varaddorle007/deck-8/docs/images/schematic-root.png

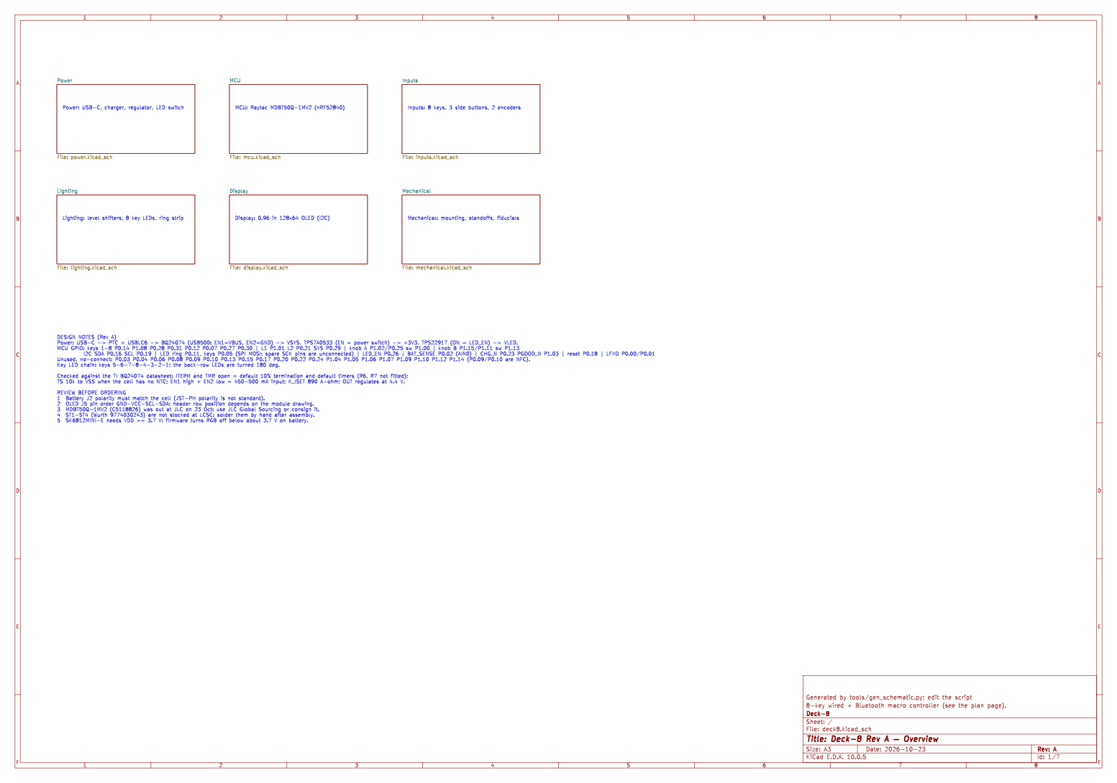
docs/images/schematic-root.png
