varaddorle007/deck-8/mechanical/exports/views_contact_sheet.png

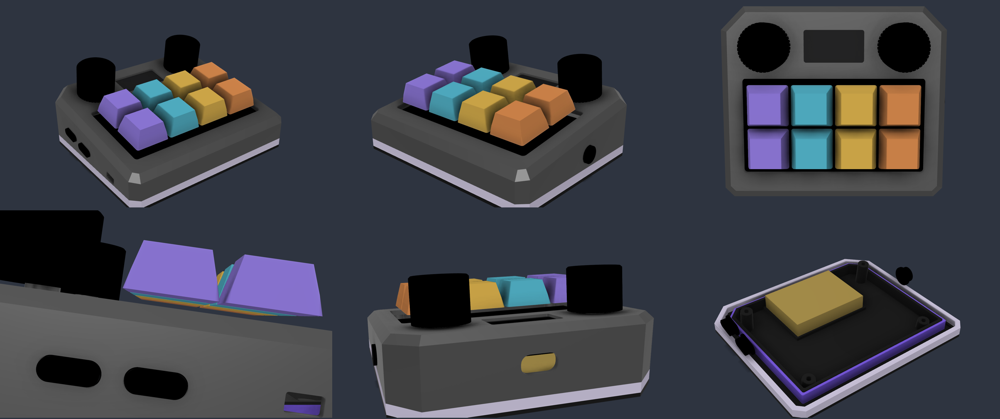
mechanical/exports/views_contact_sheet.png
