varaddorle007/deck-8/release/deck8-RevA-manufacturing/1-PCB-order-JLCPCB/deck8-RevA-bom-jlc.csv

Comment | Designator | Footprint | LCSC Part #
1u 25V CL10A105KB8NNNC (50 V X5R) | C1,C5,C7 | C_0603_1608Metric | C15849
10u 10V CL10A106KP8NNNC (10 V X5R) | C2,C9,C10,C26 | C_0603_1608Metric | C19702
4.7u 10V CL10A475KO8NNNC (16 V X5R) | C3,C12 | C_0603_1608Metric | C19666
100n CC0603KRX7R9BB104 (50 V X7R) | C4,C11,C15,C16,C17,C18,C19,C20,C21,C22,C23,C24,C27 | C_0603_1608Metric | C14663
2.2u 10V CL10A225KO8NNNC (16 V X5R) | C6 | C_0603_1608Metric | C23630
1n CL10B102KB8NNNC (50 V X7R) | C8 | C_0603_1608Metric | C1588
12p CL10C120JB8NNNC (50 V C0G) | C13,C14 | C_0603_1608Metric | C38523
100u 6.3V CL31A107MQHNNNE (1206, 6.3 V X5R) | C25 | C_1206_3216Metric | C15008
OPSCO SK6812MINI-E | D1,D2,D3,D4,D5,D6,D7,D8 | LED_SK6812MINI-E_3.2x2.8mm_P1.5mm_ReverseMount | C5149201
Littelfuse 1206L050YR (6 V) | F1 | Fuse_1206_3216Metric | C163512
HRO TYPE-C-31-M-12 | J1 | USB_C_Receptacle_HRO_TYPE-C-31-M-12 | C165948
JST S2B-PH-SM4-TB(LF)(SN) | J2 | JST_PH_S2B-PH-SM4-TB_1x02-1MP_P2.00mm_Horizontal | C295747
Joint Tech A1001WR-S-03P (JST SH compatible) | J4 | JST_SH_SM03B-SRSS-TB_1x03-1MP_P1.00mm_Horizontal | C371509
HanElectricity CPG151101S11-16 (MX hot-swap socket) | K1,K2,K3,K4,K5,K6,K7,K8 | SW_MX_Hotswap_Kailh_1u_NorthLED | C41430893
5.1k UNI-ROYAL 0603WAF5101T5E | R1,R2 | R_0603_1608Metric | C23186
10k UNI-ROYAL 0603WAF1002T5E | R3 | R_0603_1608Metric | C25804
1.8k UNI-ROYAL 0603WAF1801T5E | R4 | R_0603_1608Metric | C4177
1.5k UNI-ROYAL 0603WAF1501T5E | R5 | R_0603_1608Metric | C22843
100k UNI-ROYAL 0603WAF1003T5E | R8,R9,R13 | R_0603_1608Metric | C25803
1M UNI-ROYAL 0603WAF1004T5E | R10,R11,R12 | R_0603_1608Metric | C22935
0R UNI-ROYAL 0603WAF0000T5E | R14,R15,R20 | R_0603_1608Metric | C21189
33 UNI-ROYAL 0603WAF330JT5E | R16 | R_0603_1608Metric | C23140
330 UNI-ROYAL 0603WAF3300T5E | R17 | R_0603_1608Metric | C23138
4.7k UNI-ROYAL 0603WAF4701T5E | R18,R19 | R_0603_1608Metric | C23162
C&K PCM12SMTR | SW1 | SW_SPDT_PCM12 | C221841
C&K PTS810SJK250SMTRLFS | SW2 | SW_SPST_PTS810 | C221896
Alps SKRTLAE010 | SW3,SW4,SW5 | SW_Push_1P1T-MP_NO_Horizontal_Alps_SKRTLAE010 | C110293
ST USBLC6-2SC6 | U1 | SOT-23-6 | C7519
TI BQ24074RGTT | U2 | VQFN-16-1EP_3x3mm_P0.5mm_EP1.6x1.6mm_ThermalVias | C2861252
TI TPS7A0533PDBVR | U3 | SOT-23-5 | C493453
TI TPS22917DBVR | U4 | SOT-23-6 | C2681320
Raytac MDBT50Q-1MV2 | U5 | Raytac_MDBT50Q | C5118826
TI SN74LV1T125DBVR | U6,U7 | SOT-23-5 | C473338
Seiko SC-32S 32.768kHz 20ppm 9pF | Y1 | Crystal_SMD_3215-2Pin_3.2x1.5mm | C97605
