varaddorle007/deck-8/mechanical/exports/deck8_assembly.step

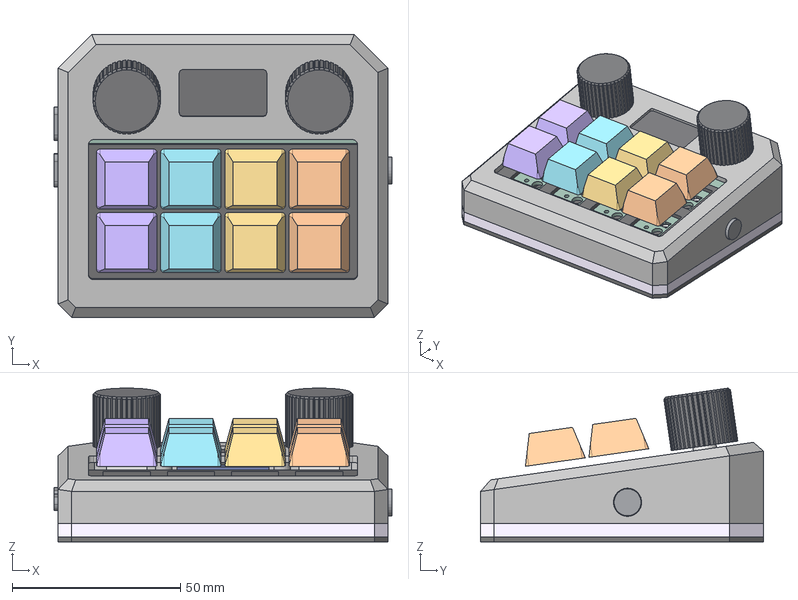
[picture p22: CAD file, 2026-10-23]
mechanical/exports/deck8_assembly.step
100.4 x 84.0 x 45.7 mm
Fusion_sp
C_0603_1608Metric_1 x 26
SOT-23-5_1 x 3
R_0603_1608Metric_1 x 20
C_1206_3216Metric_1
SOT-23-6_1 x 2
Mounting_Wuerth_WA-SMSI-M2_H3mm_9774030243_1 x 4
Pin1 x 8
Pin2 x 8
Pin3 x 8
Pin4 x 8
Crystal_SMD_3215-2Pin_3.2x1.5mm_1
JST_SH_SM03B-SRSS-TB_1x03-1MP_P1.00mm_Horizontal_1
SW_SPST_PTS810_1
Fuse_1206_3216Metric_1
Raytac_MDBT50Q_1
deck8_PCB
