varaddorle007/deck-8/hardware/exports/deck8_pcb.step

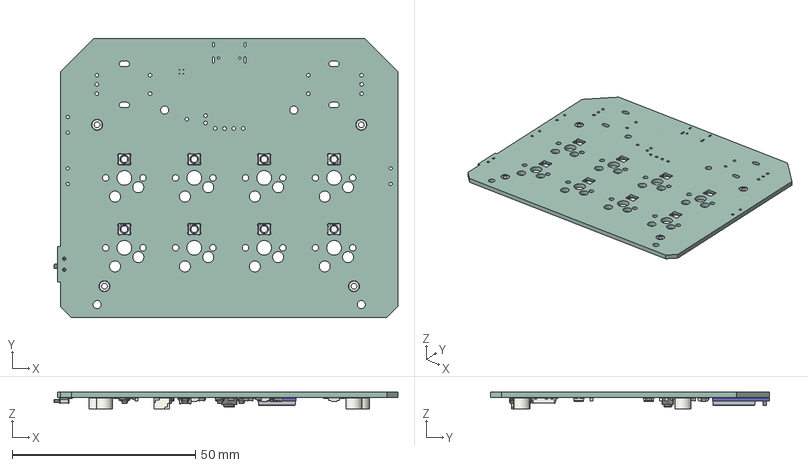
[picture p23: CAD file, 2026-10-23]
hardware/exports/deck8_pcb.step
93.8 x 76.0 x 4.60 mm
Fusion_sp
C_0603_1608Metric x 26
SOT-23-5 x 3
R_0603_1608Metric x 20
C_1206_3216Metric
SOT-23-6 x 2
Mounting_Wuerth_WA-SMSI-M2_H3mm_9774030243 x 4
Pin1 x 8
Pin2 x 8
Pin3 x 8
Pin4 x 8
Crystal_SMD_3215-2Pin_3.2x1.5mm
JST_SH_SM03B-SRSS-TB_1x03-1MP_P1.00mm_Horizontal
SW_SPST_PTS810
Fuse_1206_3216Metric
Raytac_MDBT50Q
deck8_PCB
