varaddorle007/deck-8/mechanical/exports/stl/Button_System.stl

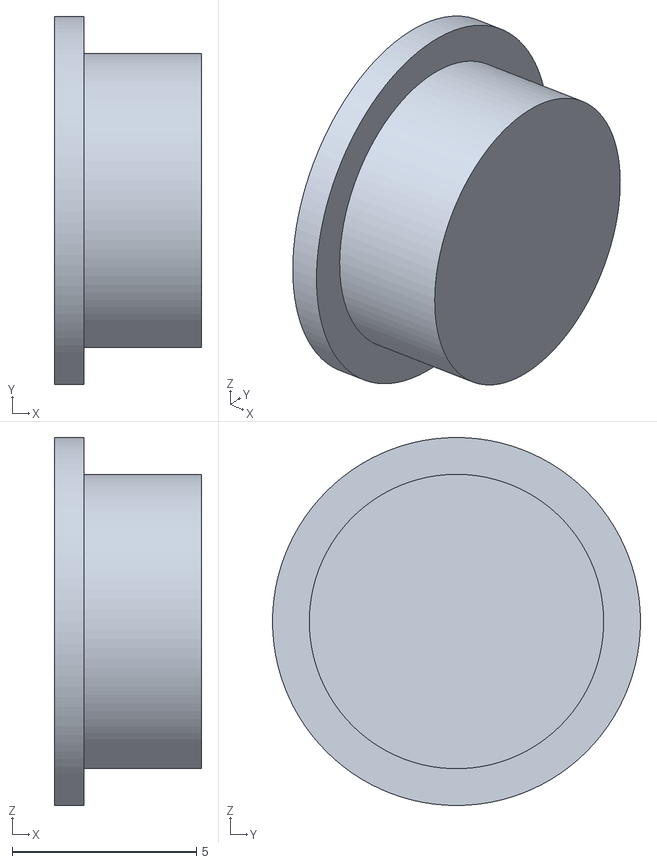
[picture p24: CAD file, 2026-10-23]
mechanical/exports/stl/Button_System.stl
4.00 x 10.0 x 10.00
