varaddorle007/deck-8/release/deck8-RevA-manufacturing/3-Enclosure/laser-cut-DXF/Deck8_Switch_Plate_1.5mm.dxf

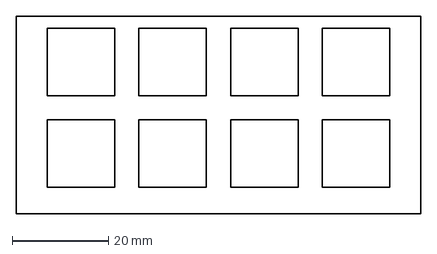
[picture p25: CAD file, 2026-10-23]
release/deck8-RevA-manufacturing/3-Enclosure/laser-cut-DXF/Deck8_Switch_Plate_1.5mm.dxf
84.0 x 41.0 mm
