varaddorle007/deck-8/release/deck8-RevA-manufacturing/3-Enclosure/print-STL/Deck8_Light_Ring.stl

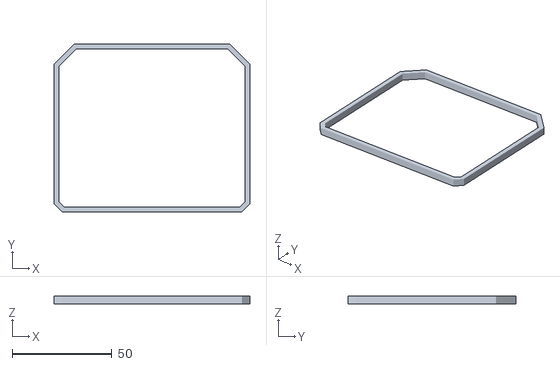
[picture p26: CAD file, 2026-10-23]
release/deck8-RevA-manufacturing/3-Enclosure/print-STL/Deck8_Light_Ring.stl
98.0 x 84.0 x 4.00
