varaddorle007/deck-8/mechanical/exports/stl/Button_L1.stl

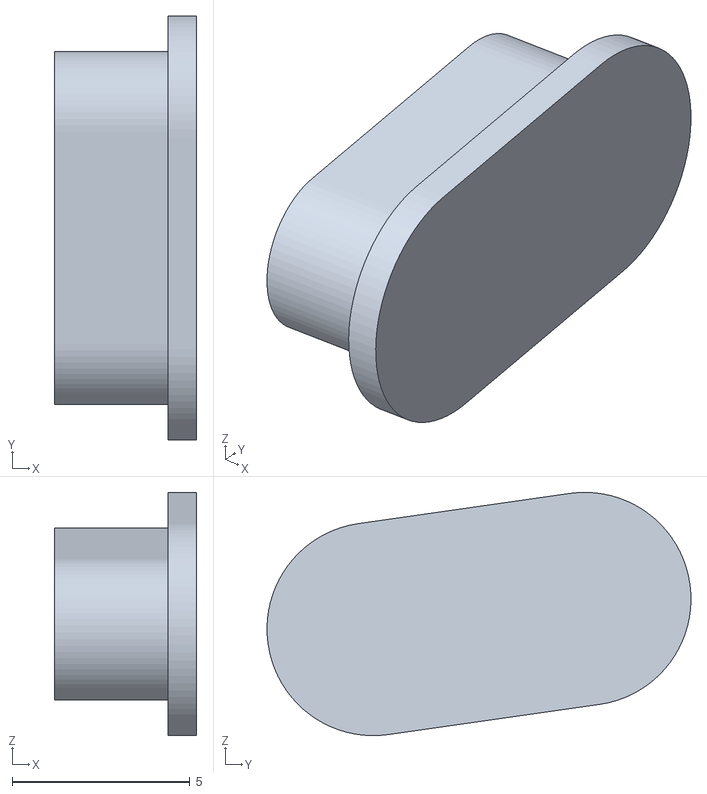
[picture p27: CAD file, 2026-10-23]
mechanical/exports/stl/Button_L1.stl
4.00 x 11.9 x 6.85
