varaddorle007/deck-8/release/deck8-RevA-manufacturing/3-Enclosure/laser-cut-DXF/Deck8_OLED_Lens_1mm_acrylic.dxf

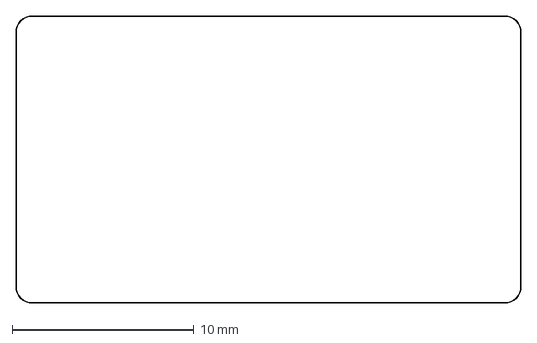
[picture p28: CAD file, 2026-10-23]
release/deck8-RevA-manufacturing/3-Enclosure/laser-cut-DXF/Deck8_OLED_Lens_1mm_acrylic.dxf
27.8 x 15.8 mm
