varaddorle007/deck-8/mechanical/exports/stl/Top_Shell.stl

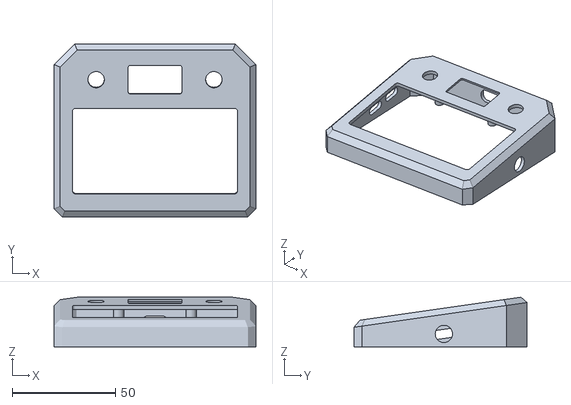
[picture p29: CAD file, 2026-10-23]
mechanical/exports/stl/Top_Shell.stl
98.0 x 84.0 x 24.1
