varaddorle007/deck-8/mechanical/exports/stl/OLED_Lens.stl

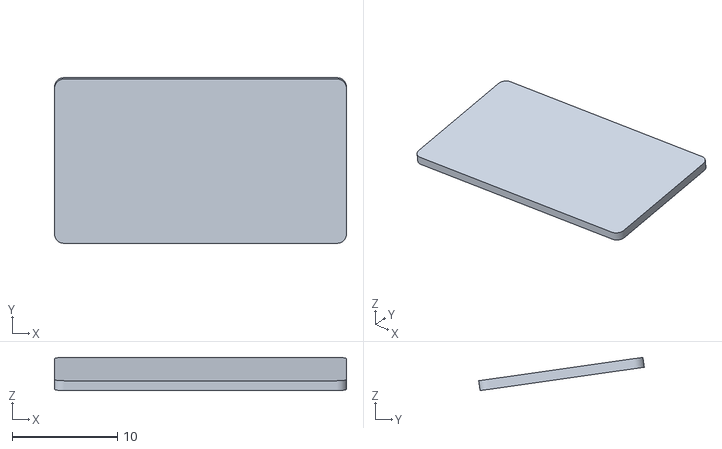
[picture p30: CAD file, 2026-10-23]
mechanical/exports/stl/OLED_Lens.stl
27.8 x 15.8 x 3.17
