varaddorle007/deck-8/release/deck8-RevA-manufacturing/3-Enclosure/print-STL/Deck8_Knob_x2.stl

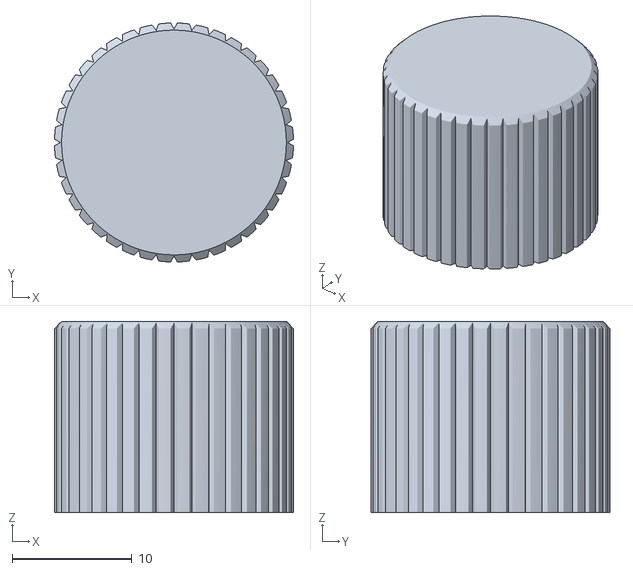
[picture p31: CAD file, 2026-10-23]
release/deck8-RevA-manufacturing/3-Enclosure/print-STL/Deck8_Knob_x2.stl
20.0 x 20.0 x 16.0
