varaddorle007/deck-8/mechanical/exports/stl/Switch_Plate.stl

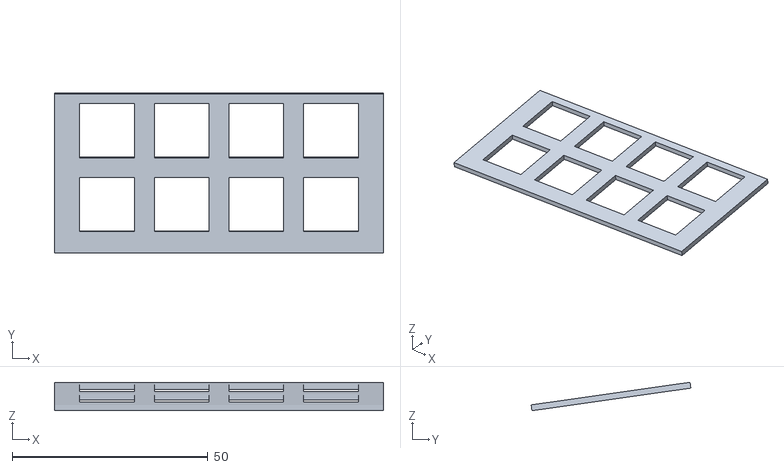
[picture p32: CAD file, 2026-10-23]
mechanical/exports/stl/Switch_Plate.stl
84.0 x 40.8 x 7.26
