varaddorle007/deck-8/release/deck8-RevA-manufacturing/3-Enclosure/print-STL/Deck8_Bottom_Tray.stl

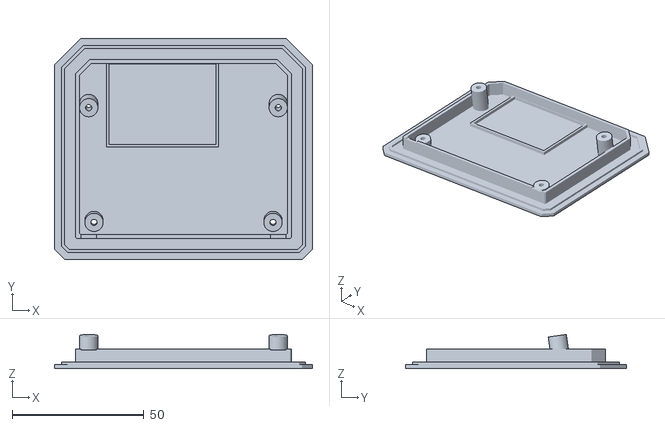
[picture p33: CAD file, 2026-10-23]
release/deck8-RevA-manufacturing/3-Enclosure/print-STL/Deck8_Bottom_Tray.stl
98.0 x 84.0 x 13.0
