varaddorle007/deck-8/release/deck8-RevA-manufacturing/3-Enclosure/print-STL/Deck8_Switch_Plate.stl

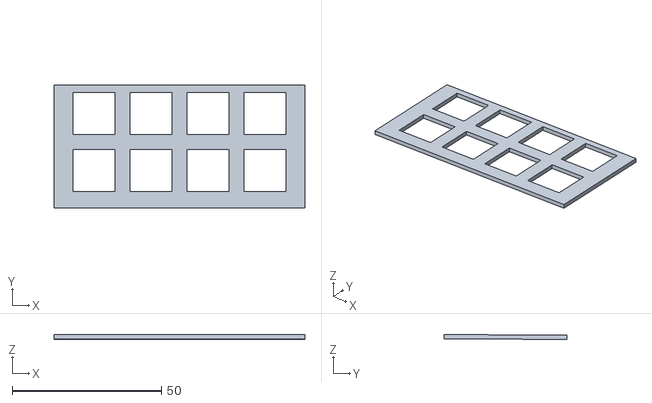
[picture p34: CAD file, 2026-10-23]
release/deck8-RevA-manufacturing/3-Enclosure/print-STL/Deck8_Switch_Plate.stl
84.0 x 41.0 x 1.52
