varaddorle007/deck-8/release/deck8-RevA-manufacturing/3-Enclosure/print-STL/Deck8_OLED_Lens.stl

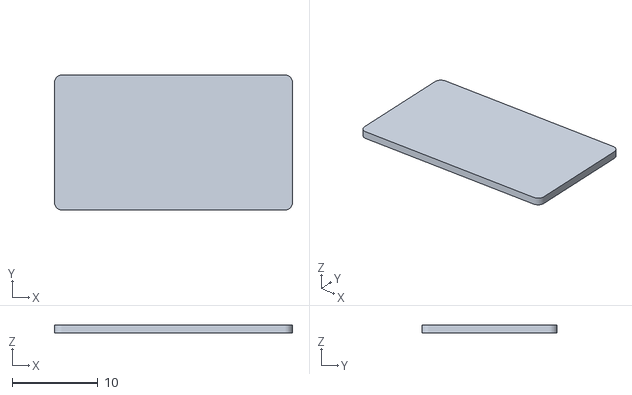
[picture p35: CAD file, 2026-10-23]
release/deck8-RevA-manufacturing/3-Enclosure/print-STL/Deck8_OLED_Lens.stl
27.8 x 15.8 x 0.958
