varaddorle007/deck-8/(list of files, cad)

Other CAD files:
release/deck8-RevA-manufacturing/3-Enclosure/print-STL/Deck8_Button_L1.stl
release/deck8-RevA-manufacturing/3-Enclosure/print-STL/Deck8_Top_Shell.stl
mechanical/exports/stl/Button_L2.stl
release/deck8-RevA-manufacturing/3-Enclosure/print-STL/Deck8_Button_L2.stl
mechanical/exports/stl/Knob.stl
mechanical/exports/stl/Light_Ring.stl
release/deck8-RevA-manufacturing/3-Enclosure/print-STL/Deck8_Button_System.stl
mechanical/exports/stl/Bottom_Tray.stl
mechanical/exports/deck8_assembly.f3d
