varaddorle007/deck-8/release/deck8-RevA-manufacturing/2-PCB-reference/check_gerbers.png

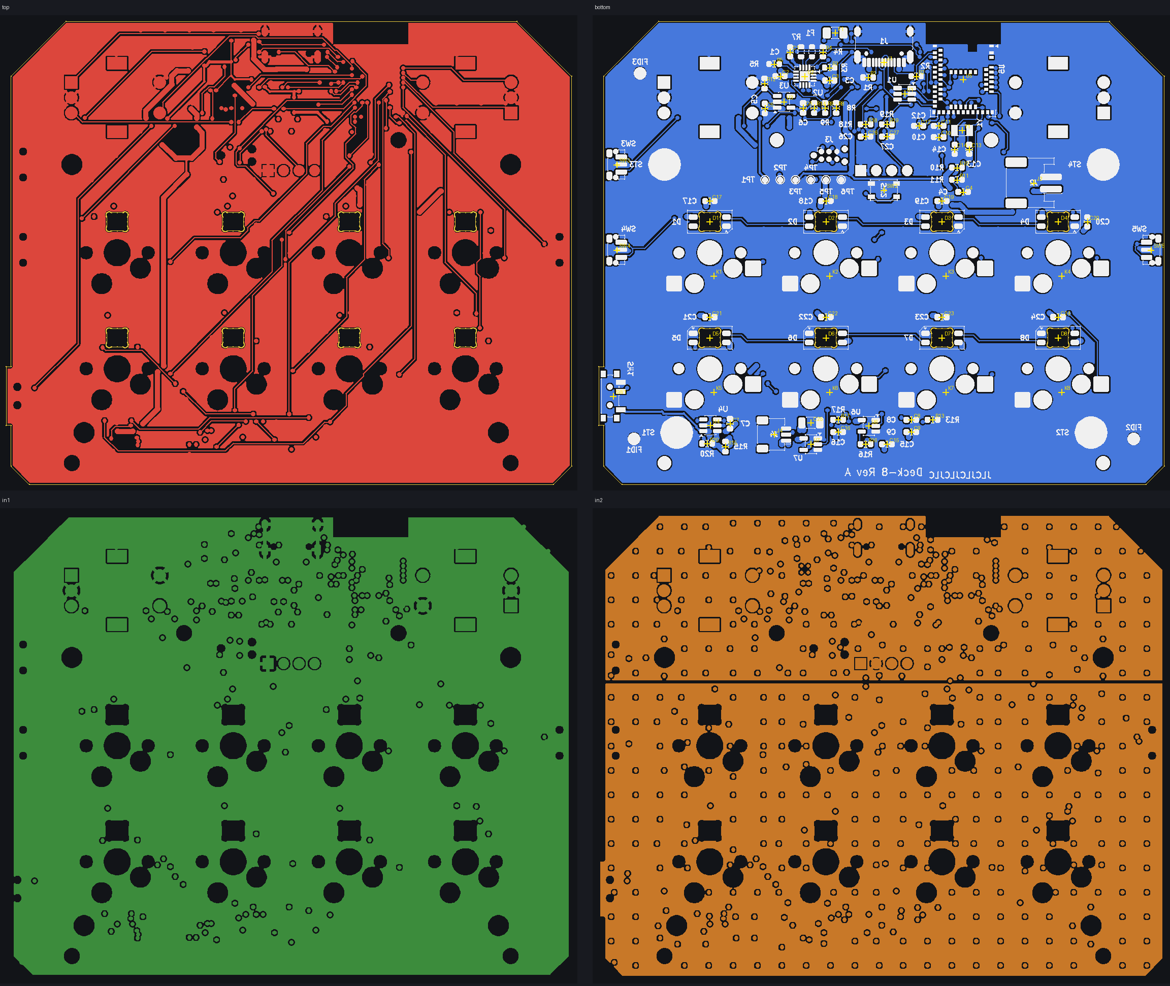
release/deck8-RevA-manufacturing/2-PCB-reference/check_gerbers.png
