varaddorle007/deck-8/release/deck8-RevA-manufacturing/2-PCB-reference/deck8-RevA-assembly-bottom.pdf

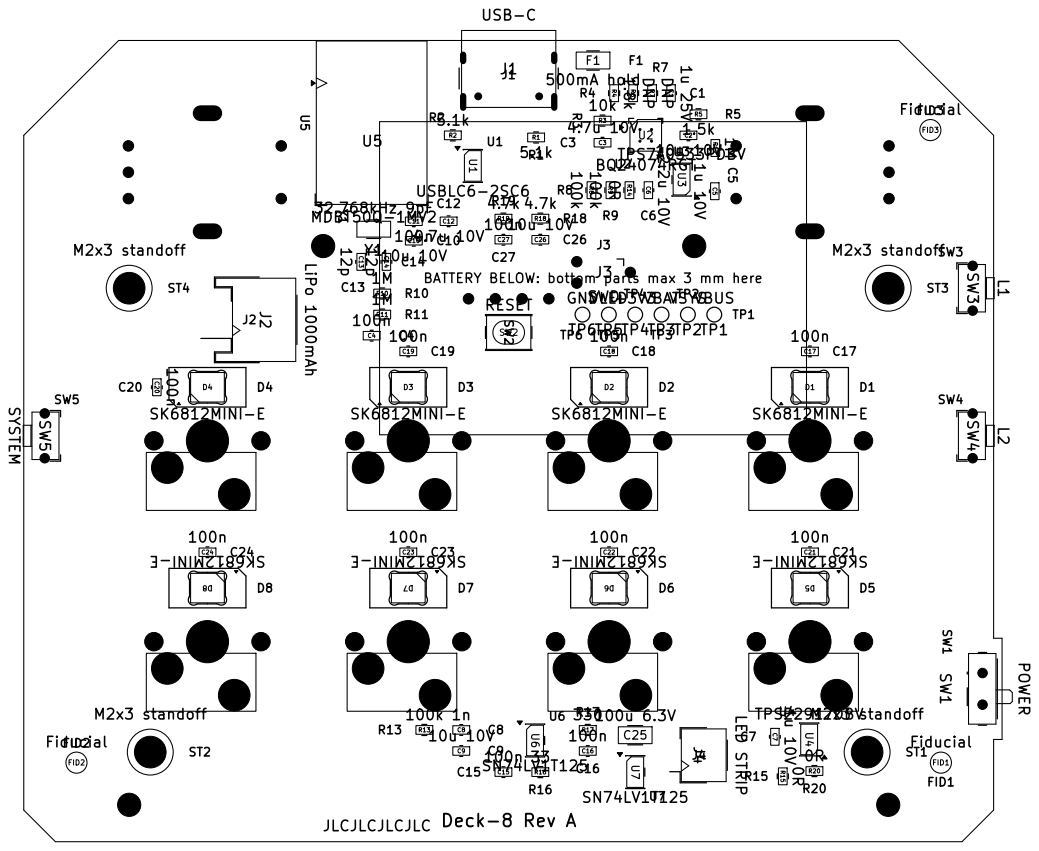
[picture p43: page 1]

4 layers: F.Cu signal, In1 GND, In2 power, B.Cu parts + signal
Generated by tools/gen_pcb.py from placement.json + schematic netlist
Deck-8
Sheet:
File: deck8.kicad_pcb
Title: Deck-8 Rev A main PCB

Size: A4 | Rev: A
KiCad E.D.A. 10.0.5 | Id: 1/1
