varaddorle007/deck-8/hardware/main/deck8.kicad_pcb

## KiCad design hardware/main/deck8.kicad_pcb (2026-10-23)

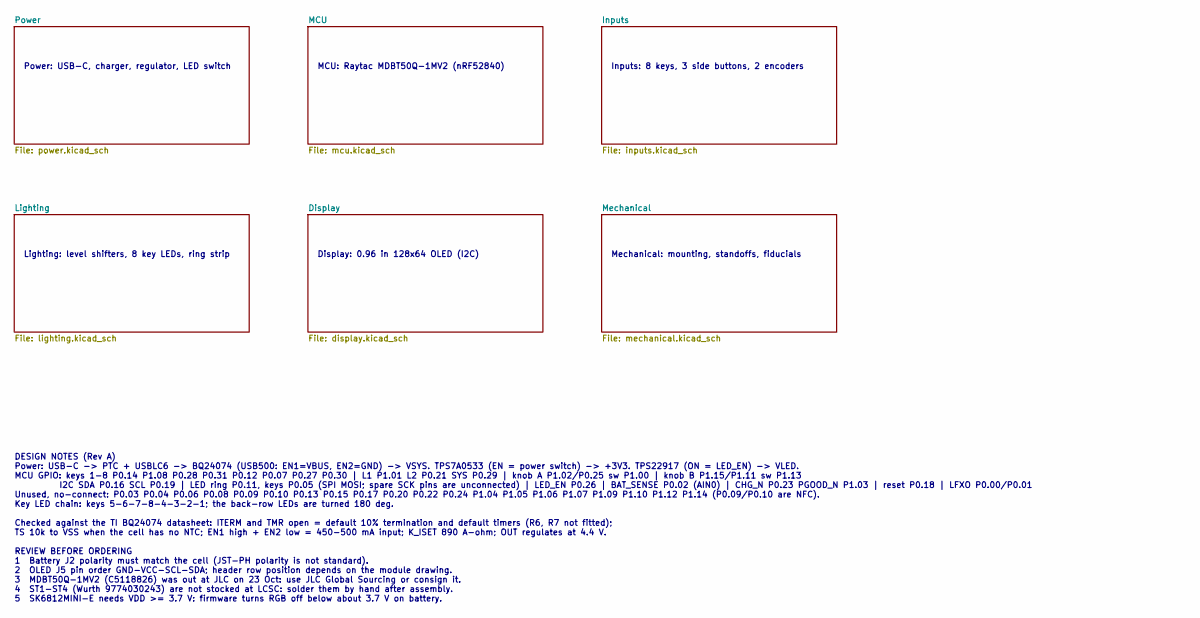
[picture p44: schematic deck8.kicad_sch, Deck-8 Rev A — Overview]

Notes on the sheet:
Power: USB-C, charger, regulator, LED switch
MCU: Raytac MDBT50Q-1MV2 (nRF52840)
Inputs: 8 keys, 3 side buttons, 2 encoders
Lighting: level shifters, 8 key LEDs, ring strip
Display: 0.96 in 128x64 OLED (I2C)
Mechanical: mounting, standoffs, fiducials
DESIGN NOTES (Rev A) Power: USB-C -> PTC + USBLC6 -> BQ24074 (USB500: EN1=VBUS, EN2=GND) -> VSYS. TPS7A0533 (EN = power switch) -> +3V3. TPS22917 (ON = LED_EN) -> VLED. MCU GPIO: keys 1-8 P0.14 P1.08 P0.28 P0.31 P0.12 P0.07 P0.27 P0.30 | L1 P1.01 L2 P0.21 SYS P0.29 | knob A P1.02/P0.25 sw P1.00 | k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

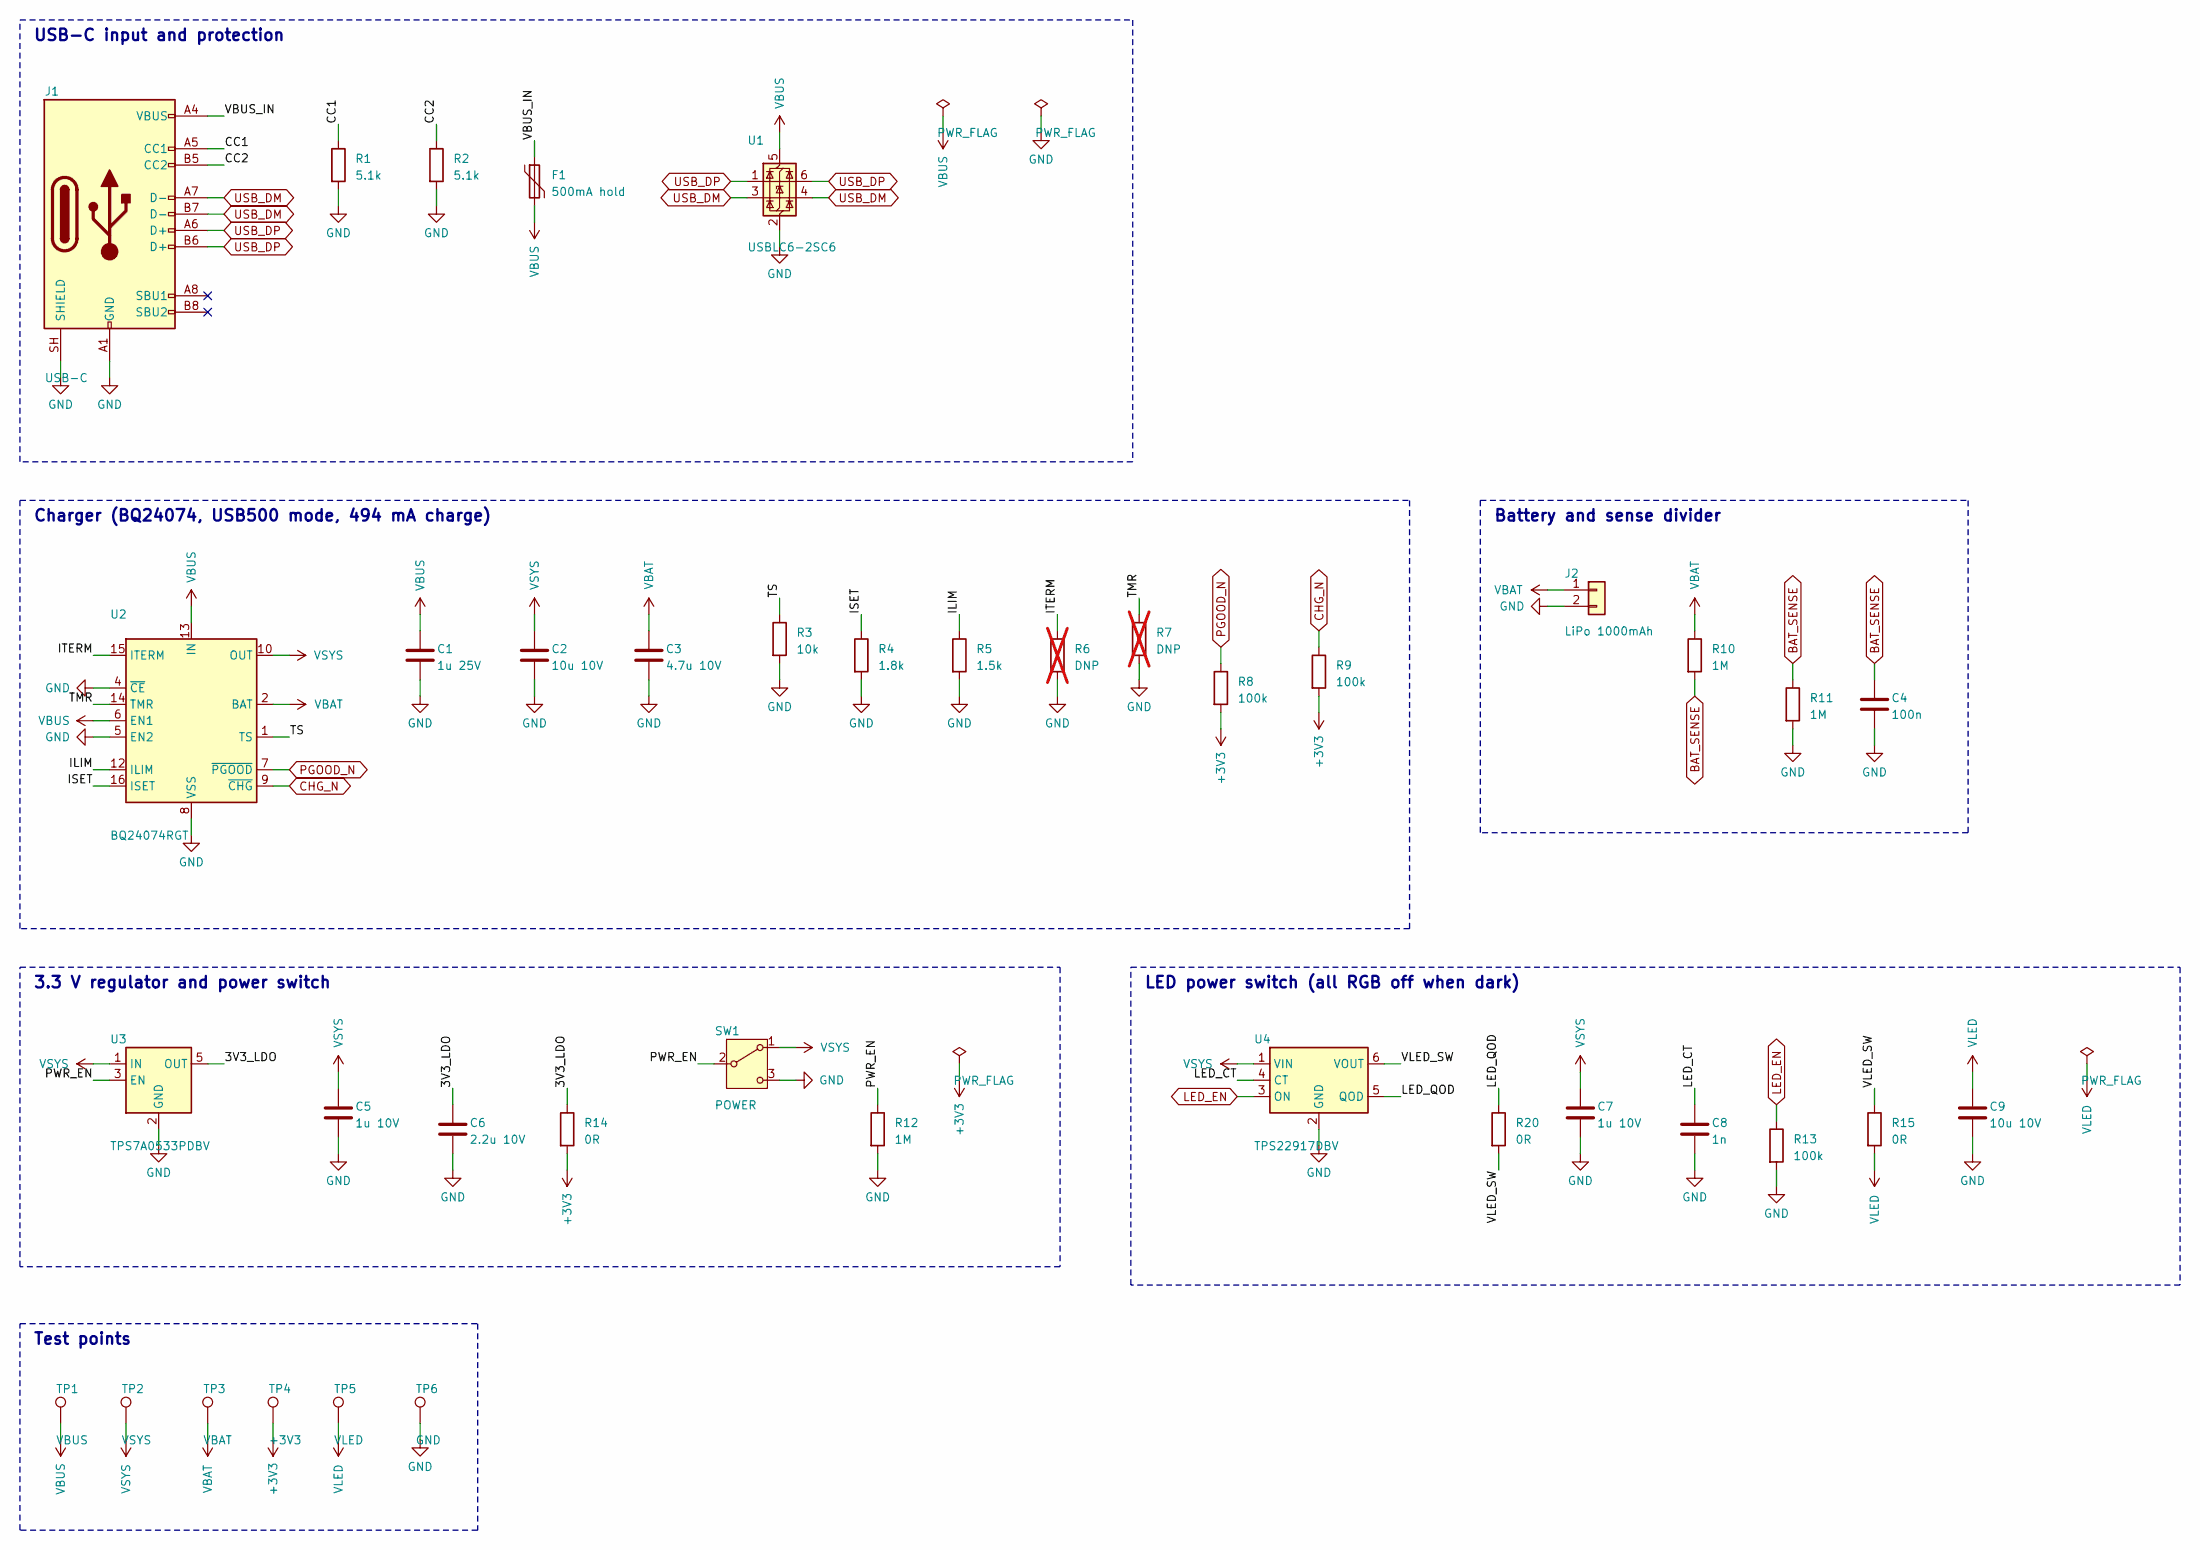
[picture p45: schematic power.kicad_sch, Deck-8 Rev A — Power: USB-C, charger, regulator, LED switch]

Parts:
C1: 1u 25V; C_0603_1608Metric; MPN CL10A105KB8NNNC (50 V X5R); LCSC C15849
C2, C9: 10u 10V; C_0603_1608Metric; MPN CL10A106KP8NNNC (10 V X5R); LCSC C19702
C3: 4.7u 10V; C_0603_1608Metric; MPN CL10A475KO8NNNC (16 V X5R); LCSC C19666
C4: 100n; C_0603_1608Metric; MPN CC0603KRX7R9BB104 (50 V X7R); LCSC C14663
C5, C7: 1u 10V; C_0603_1608Metric; MPN CL10A105KB8NNNC (50 V X5R); LCSC C15849
C6: 2.2u 10V; C_0603_1608Metric; MPN CL10A225KO8NNNC (16 V X5R); LCSC C23630
C8: 1n; C_0603_1608Metric; MPN CL10B102KB8NNNC (50 V X7R); LCSC C1588
F1: 500mA hold; Fuse_1206_3216Metric; MPN Littelfuse 1206L050YR (6 V); LCSC C163512
J1: USB-C; USB_C_Receptacle_HRO_TYPE-C-31-M-12; MPN HRO TYPE-C-31-M-12; LCSC C165948
J2: LiPo 1000mAh; JST_PH_S2B-PH-SM4-TB_1x02-1MP_P2.00mm_Horizontal; MPN JST S2B-PH-SM4-TB(LF)(SN); LCSC C295747
R1, R2: 5.1k; R_0603_1608Metric; MPN UNI-ROYAL 0603WAF5101T5E; LCSC C23186
R3: 10k; R_0603_1608Metric; MPN UNI-ROYAL 0603WAF1002T5E; LCSC C25804
R4: 1.8k; R_0603_1608Metric; MPN UNI-ROYAL 0603WAF1801T5E; LCSC C4177
R5: 1.5k; R_0603_1608Metric; MPN UNI-ROYAL 0603WAF1501T5E; LCSC C22843
R6, R7: DNP; R_0603_1608Metric; not fitted
R8, R9, R13: 100k; R_0603_1608Metric; MPN UNI-ROYAL 0603WAF1003T5E; LCSC C25803
R10, R11, R12: 1M; R_0603_1608Metric; MPN UNI-ROYAL 0603WAF1004T5E; LCSC C22935
R14, R15, R20: 0R; R_0603_1608Metric; MPN UNI-ROYAL 0603WAF0000T5E; LCSC C21189
SW1: POWER; SW_SPDT_PCM12; MPN C&K PCM12SMTR; LCSC C221841
TP1: VBUS; TestPoint_Pad_D1.0mm
TP2: VSYS; TestPoint_Pad_D1.0mm
TP3: VBAT; TestPoint_Pad_D1.0mm
TP4: +3V3; TestPoint_Pad_D1.0mm
TP5: VLED; TestPoint_Pad_D1.0mm
TP6: GND; TestPoint_Pad_D1.0mm
U1: USBLC6-2SC6; SOT-23-6; MPN ST USBLC6-2SC6; LCSC C7519
U2: BQ24074RGT; VQFN-16-1EP_3x3mm_P0.5mm_EP1.6x1.6mm_ThermalVias; MPN TI BQ24074RGTT; LCSC C2861252
U3: TPS7A0533PDBV; SOT-23-5; MPN TI TPS7A0533PDBVR; LCSC C493453
U4: TPS22917DBV; SOT-23-6; MPN TI TPS22917DBVR; LCSC C2681320

Connections:
+3V3: R8.2, R9.2, R14.2, TP4.1; also elsewhere on the board
/Power/3V3_LDO: C6.1, R14.1, U3.5 (OUT)
/Power/CC1: J1.A5 (CC1), R1.1
/Power/CC2: J1.B5 (CC2), R2.1
/Power/ILIM: R5.1, U2.12 (ILIM)
/Power/ISET: R4.1, U2.16 (ISET)
/Power/ITERM: R6.1, U2.15 (ITERM)
/Power/LED_CT: C8.1, U4.4 (CT)
/Power/LED_QOD: R20.1, U4.5 (QOD)
/Power/PWR_EN: R12.1, SW1.2 (B), U3.3 (EN)
/Power/TMR: R7.1, U2.14 (TMR)
/Power/TS: R3.1, U2.1 (TS)
/Power/VBUS_IN: F1.1, J1.A4 (VBUS), J1.A9 (VBUS), J1.B4 (VBUS), J1.B9 (VBUS)
/Power/VLED_SW: R15.1, R20.2, U4.6 (VOUT)
BAT_SENSE: C4.1, R10.2, R11.1; also elsewhere on the board
CHG_N: R9.1, U2.9 (~CHG); also elsewhere on the board
GND: C1.2, C2.2, C3.2, C4.2, C5.2, C6.2, C7.2, C8.2, C9.2, J1.A1 (GND), J1.A12 (GND), J1.B1 (GND), J1.B12 (GND), J1.SH (SHIELD), J2.2, R1.2, R2.2, R3.2, R4.2, R5.2, R6.2, R7.2, R11.2, R12.2, R13.2, SW1.3 (C), TP6.1, U1.2 (GND), U2.4 (~CE), U2.5 (EN2), U2.8 (VSS), U2.17 (VSS), U3.2 (GND), U4.2 (GND); also elsewhere on the board
LED_EN: R13.1, U4.3 (ON); also elsewhere on the board
PGOOD_N: R8.1, U2.7 (~PGOOD); also elsewhere on the board
USB_DM: J1.A7 (D-), J1.B7 (D-), U1.3 (I/O2), U1.4 (I/O2); also elsewhere on the board
USB_DP: J1.A6 (D+), J1.B6 (D+), U1.1 (I/O1), U1.6 (I/O1); also elsewhere on the board
VBAT: C3.1, J2.1, R10.1, TP3.1, U2.2 (BAT), U2.3 (BAT)
VBUS: C1.1, F1.2, TP1.1, U1.5 (VBUS), U2.6 (EN1), U2.13 (IN); also elsewhere on the board
VLED: C9.1, R15.2, TP5.1; also elsewhere on the board
VSYS: C2.1, C5.1, C7.1, SW1.1 (A), TP2.1, U2.10 (OUT), U2.11 (OUT), U3.1 (IN), U4.1 (VIN)

Notes on the sheet:
USB-C input and protection
Charger (BQ24074, USB500 mode, 494 mA charge)
Battery and sense divider
3.3 V regulator and power switch
LED power switch (all RGB off when dark)
Test points

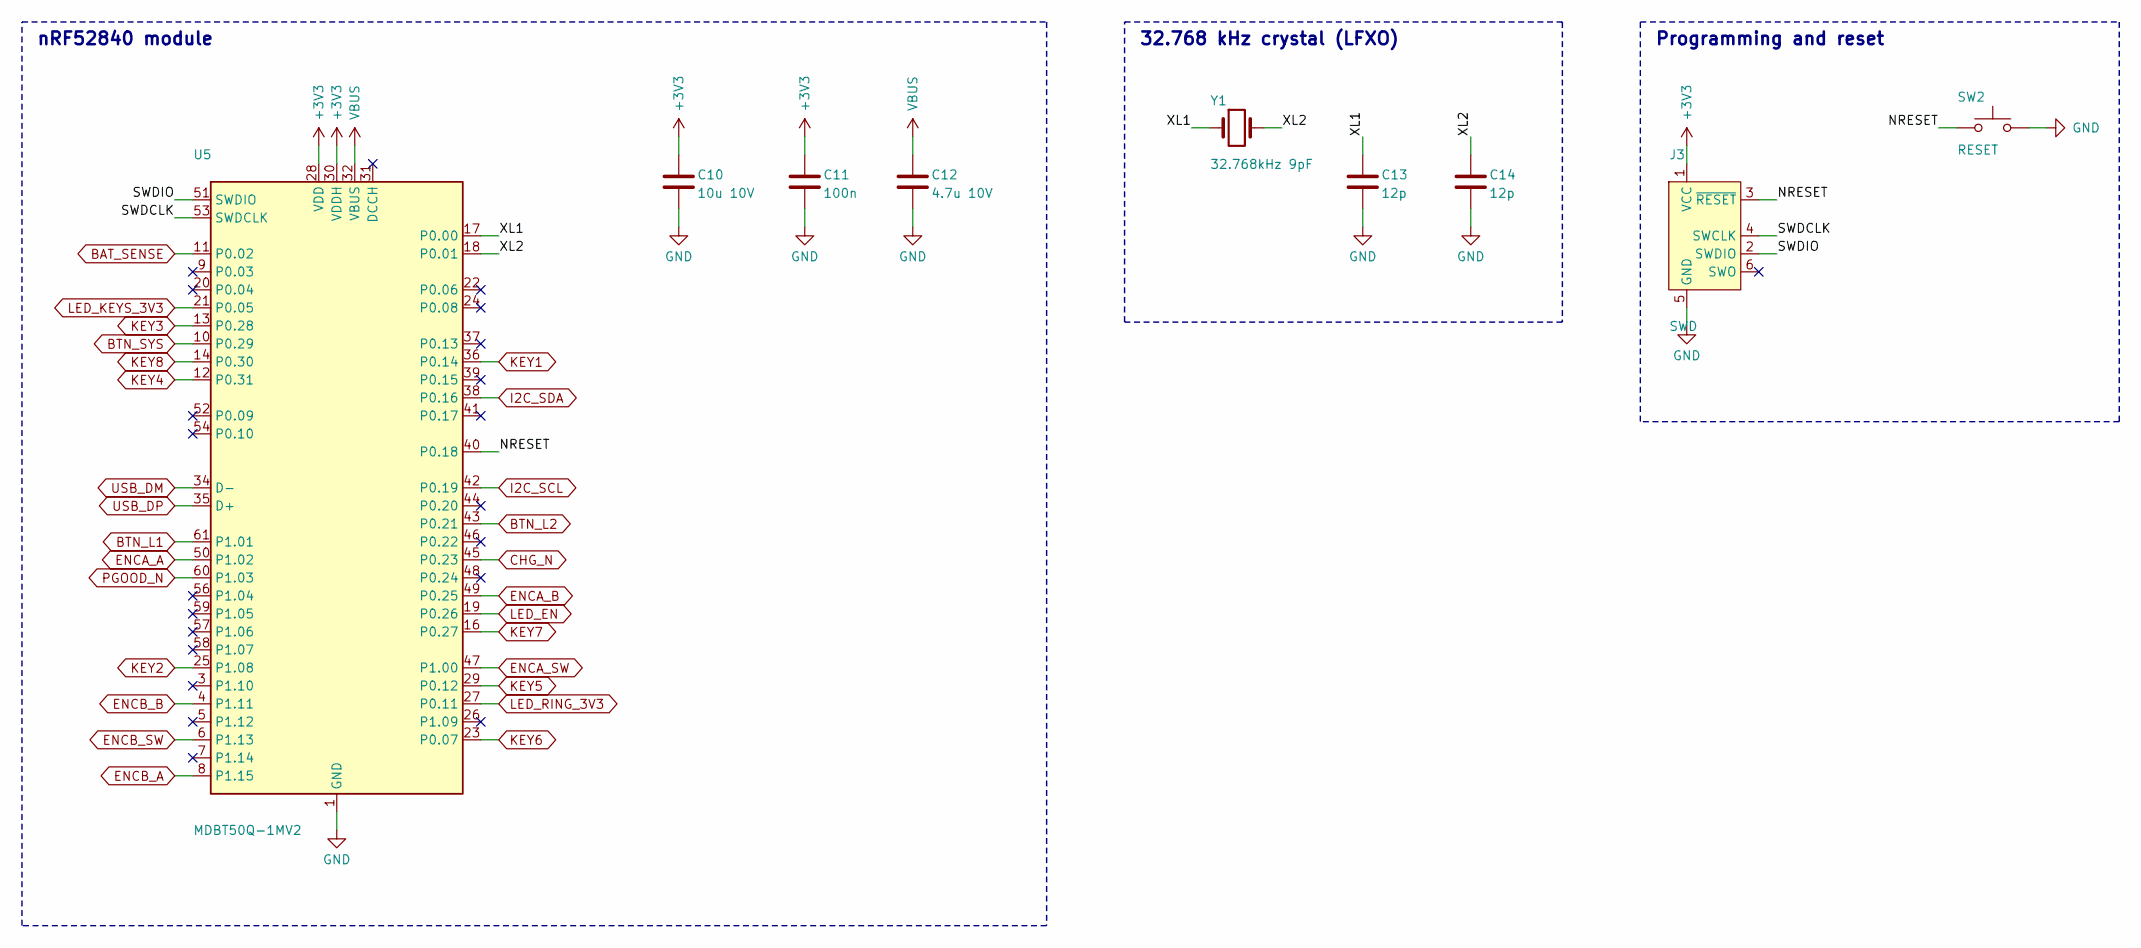
[picture p46: schematic mcu.kicad_sch, Deck-8 Rev A — MCU: Raytac MDBT50Q-1MV2 (nRF52840)]

Parts:
C10: 10u 10V; C_0603_1608Metric; MPN CL10A106KP8NNNC (10 V X5R); LCSC C19702
C11: 100n; C_0603_1608Metric; MPN CC0603KRX7R9BB104 (50 V X7R); LCSC C14663
C12: 4.7u 10V; C_0603_1608Metric; MPN CL10A475KO8NNNC (16 V X5R); LCSC C19666
C13, C14: 12p; C_0603_1608Metric; MPN CL10C120JB8NNNC (50 V C0G); LCSC C38523
J3: SWD; Tag-Connect_TC2030-IDC-NL_2x03_P1.27mm_Vertical
SW2: RESET; SW_SPST_PTS810; MPN C&K PTS810SJK250SMTRLFS; LCSC C221896
U5: MDBT50Q-1MV2; Raytac_MDBT50Q; MPN Raytac MDBT50Q-1MV2; LCSC C5118826
Y1: 32.768kHz 9pF; Crystal_SMD_3215-2Pin_3.2x1.5mm; MPN Seiko SC-32S 32.768kHz 20ppm 9pF; LCSC C97605

Connections:
+3V3: C10.1, C11.1, J3.1 (VCC), U5.28 (VDD), U5.30 (VDDH); also elsewhere on the board
/MCU/NRESET: J3.3 (~RESET), SW2.1, U5.40 (P0.18)
/MCU/SWDCLK: J3.4 (SWCLK), U5.53 (SWDCLK)
/MCU/SWDIO: J3.2 (SWDIO), U5.51 (SWDIO)
/MCU/XL1: C13.1, U5.17 (P0.00), Y1.1
/MCU/XL2: C14.1, U5.18 (P0.01), Y1.2
BAT_SENSE: U5.11 (P0.02); also elsewhere on the board
BTN_L1: U5.61 (P1.01); also elsewhere on the board
BTN_L2: U5.43 (P0.21); also elsewhere on the board
BTN_SYS: U5.10 (P0.29); also elsewhere on the board
CHG_N: U5.45 (P0.23); also elsewhere on the board
ENCA_A: U5.50 (P1.02); also elsewhere on the board
ENCA_B: U5.49 (P0.25); also elsewhere on the board
ENCA_SW: U5.47 (P1.00); also elsewhere on the board
ENCB_A: U5.8 (P1.15); also elsewhere on the board
ENCB_B: U5.4 (P1.11); also elsewhere on the board
ENCB_SW: U5.6 (P1.13); also elsewhere on the board
GND: C10.2, C11.2, C12.2, C13.2, C14.2, J3.5 (GND), SW2.2, U5.1 (GND), U5.2 (GND), U5.15 (GND), U5.33 (GND), U5.55 (GND); also elsewhere on the board
I2C_SCL: U5.42 (P0.19); also elsewhere on the board
I2C_SDA: U5.38 (P0.16); also elsewhere on the board
KEY1: U5.36 (P0.14); also elsewhere on the board
KEY2: U5.25 (P1.08); also elsewhere on the board
KEY3: U5.13 (P0.28); also elsewhere on the board
KEY4: U5.12 (P0.31); also elsewhere on the board
KEY5: U5.29 (P0.12); also elsewhere on the board
KEY6: U5.23 (P0.07); also elsewhere on the board
KEY7: U5.16 (P0.27); also elsewhere on the board
KEY8: U5.14 (P0.30); also elsewhere on the board
LED_EN: U5.19 (P0.26); also elsewhere on the board
LED_KEYS_3V3: U5.21 (P0.05); also elsewhere on the board
LED_RING_3V3: U5.27 (P0.11); also elsewhere on the board
PGOOD_N: U5.60 (P1.03); also elsewhere on the board
USB_DM: U5.34 (D-); also elsewhere on the board
USB_DP: U5.35 (D+); also elsewhere on the board
VBUS: C12.1, U5.32 (VBUS); also elsewhere on the board

Notes on the sheet:
nRF52840 module
32.768 kHz crystal (LFXO)
Programming and reset

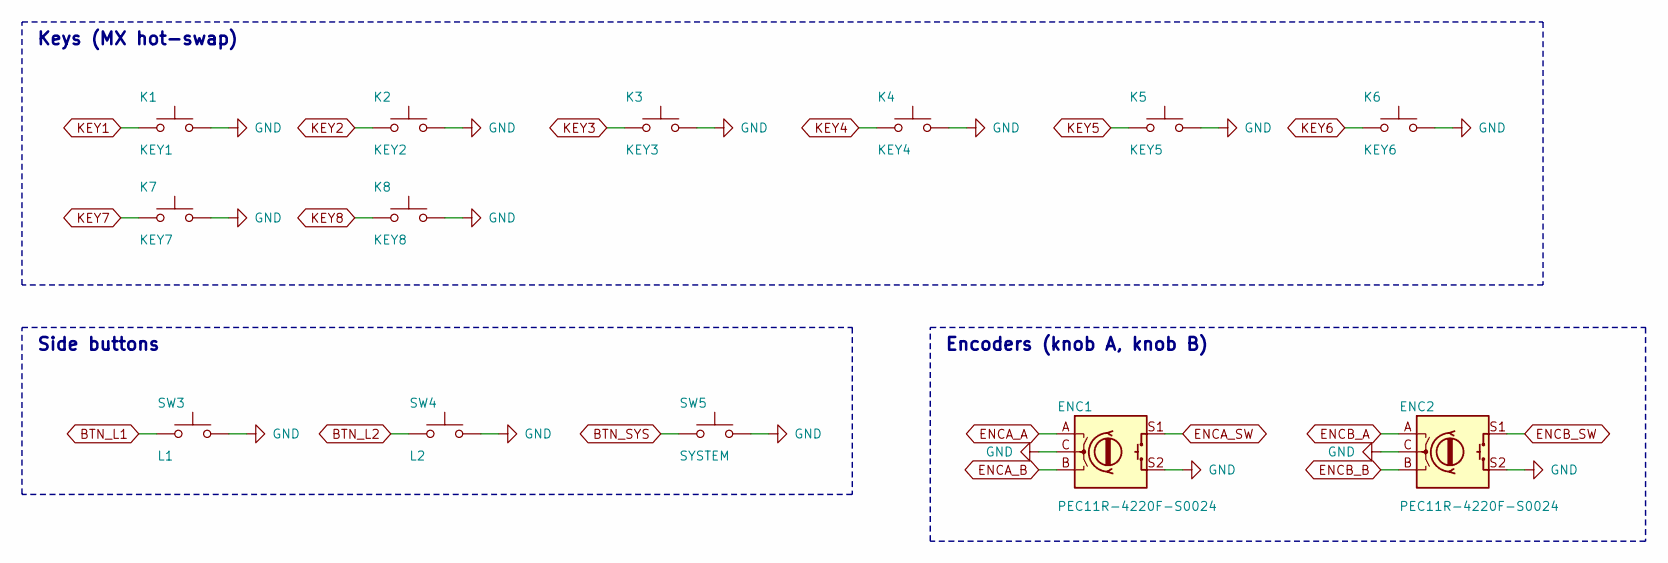
[picture p47: schematic inputs.kicad_sch, Deck-8 Rev A — Inputs: 8 keys, 3 side buttons, 2 encoders]

Parts:
ENC1, ENC2: PEC11R-4220F-S0024; RotaryEncoder_Alps_EC11E-Switch_Vertical_H20mm; MPN Bourns PEC11R-4220F-S0024
K1: KEY1; SW_MX_Hotswap_Kailh_1u_NorthLED; MPN HanElectricity CPG151101S11-16 (MX hot-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; LCSC C41430893
K2: KEY2; SW_MX_Hotswap_Kailh_1u_NorthLED; MPN HanElectricity CPG151101S11-16 (MX hot-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; LCSC C41430893
K3: KEY3; SW_MX_Hotswap_Kailh_1u_NorthLED; MPN HanElectricity CPG151101S11-16 (MX hot-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; LCSC C41430893
K4: KEY4; SW_MX_Hotswap_Kailh_1u_NorthLED; MPN HanElectricity CPG151101S11-16 (MX hot-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; LCSC C41430893
K5: KEY5; SW_MX_Hotswap_Kailh_1u_NorthLED; MPN HanElectricity CPG151101S11-16 (MX hot-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; LCSC C41430893
K6: KEY6; SW_MX_Hotswap_Kailh_1u_NorthLED; MPN HanElectricity CPG151101S11-16 (MX hot-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; LCSC C41430893
K7: KEY7; SW_MX_Hotswap_Kailh_1u_NorthLED; MPN HanElectricity CPG151101S11-16 (MX hot-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; LCSC C41430893
K8: KEY8; SW_MX_Hotswap_Kailh_1u_NorthLED; MPN HanElectricity CPG151101S11-16 (MX hot-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; LCSC C41430893
SW3: L1; SW_Push_1P1T-MP_NO_Horizontal_Alps_SKRTLAE010; MPN Alps SKRTLAE010; LCSC C110293
SW4: L2; SW_Push_1P1T-MP_NO_Horizontal_Alps_SKRTLAE010; MPN Alps SKRTLAE010; LCSC C110293
SW5: SYSTEM; SW_Push_1P1T-MP_NO_Horizontal_Alps_SKRTLAE010; MPN Alps SKRTLAE010; LCSC C110293

Connections:
BTN_L1: SW3.1; also elsewhere on the board
BTN_L2: SW4.1; also elsewhere on the board
BTN_SYS: SW5.1; also elsewhere on the board
ENCA_A: ENC1.A; also elsewhere on the board
ENCA_B: ENC1.B; also elsewhere on the board
ENCA_SW: ENC1.S1; also elsewhere on the board
ENCB_A: ENC2.A; also elsewhere on the board
ENCB_B: ENC2.B; also elsewhere on the board
ENCB_SW: ENC2.S1; also elsewhere on the board
GND: ENC1.C, ENC1.S2, ENC2.C, ENC2.S2, K1.2, K2.2, K3.2, K4.2, K5.2, K6.2, K7.2, K8.2, SW3.2, SW4.2, SW5.2; also elsewhere on the board
KEY1: K1.1; also elsewhere on the board
KEY2: K2.1; also elsewhere on the board
KEY3: K3.1; also elsewhere on the board
KEY4: K4.1; also elsewhere on the board
KEY5: K5.1; also elsewhere on the board
KEY6: K6.1; also elsewhere on the board
KEY7: K7.1; also elsewhere on the board
KEY8: K8.1; also elsewhere on the board

Notes on the sheet:
Keys (MX hot-swap)
Side buttons
Encoders (knob A, knob B)

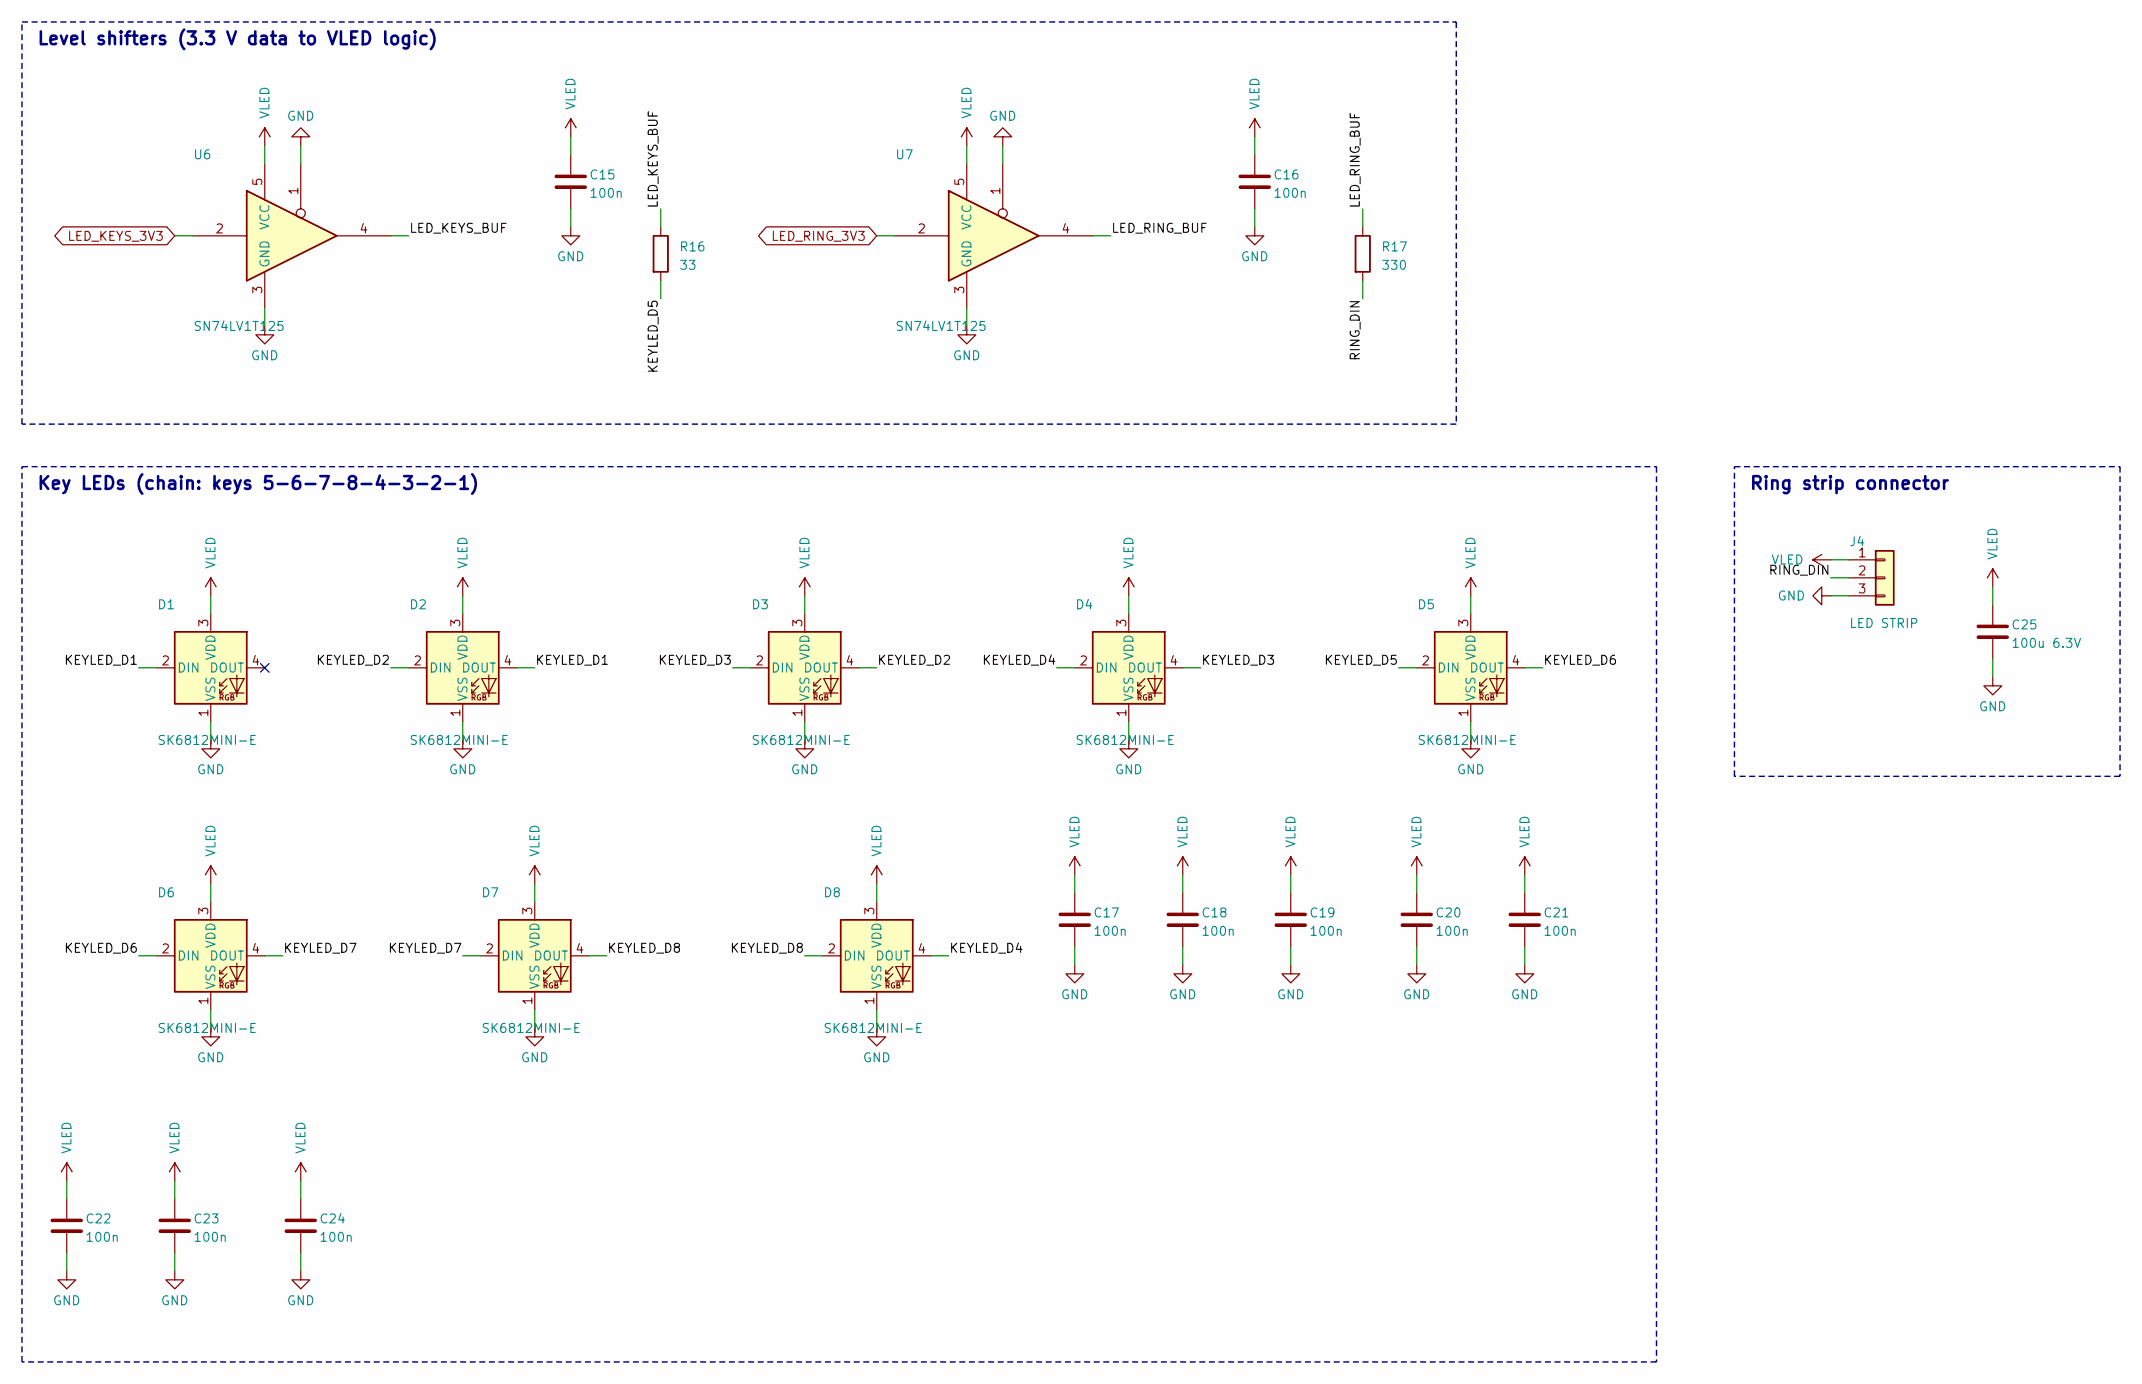
[picture p48: schematic lighting.kicad_sch, Deck-8 Rev A — Lighting: level shifters, 8 key LEDs, ring s…]

Parts:
C15, C16, C17, C18, C19, C20, C21, C22, C23, C24: 100n; C_0603_1608Metric; MPN CC0603KRX7R9BB104 (50 V X7R); LCSC C14663
C25: 100u 6.3V; C_1206_3216Metric; MPN CL31A107MQHNNNE (1206, 6.3 V X5R); LCSC C15008
D1, D2, D3, D4, D5, D6, D7, D8: SK6812MINI-E; LED_SK6812MINI-E_3.2x2.8mm_P1.5mm_ReverseMount; MPN OPSCO SK6812MINI-E; LCSC C5149201
J4: LED STRIP; JST_SH_SM03B-SRSS-TB_1x03-1MP_P1.00mm_Horizontal; MPN Joint Tech A1001WR-S-03P (JST SH compat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; LCSC C371509
R16: 33; R_0603_1608Metric; MPN UNI-ROYAL 0603WAF330JT5E; LCSC C23140
R17: 330; R_0603_1608Metric; MPN UNI-ROYAL 0603WAF3300T5E; LCSC C23138
U6, U7: SN74LV1T125; SOT-23-5; MPN TI SN74LV1T125DBVR; LCSC C473338

Connections:
/Lighting/KEYLED_D1: D1.2 (DIN), D2.4 (DOUT)
/Lighting/KEYLED_D2: D2.2 (DIN), D3.4 (DOUT)
/Lighting/KEYLED_D3: D3.2 (DIN), D4.4 (DOUT)
/Lighting/KEYLED_D4: D4.2 (DIN), D8.4 (DOUT)
/Lighting/KEYLED_D5: D5.2 (DIN), R16.2
/Lighting/KEYLED_D6: D5.4 (DOUT), D6.2 (DIN)
/Lighting/KEYLED_D7: D6.4 (DOUT), D7.2 (DIN)
/Lighting/KEYLED_D8: D7.4 (DOUT), D8.2 (DIN)
/Lighting/LED_KEYS_BUF: R16.1, U6.4
/Lighting/LED_RING_BUF: R17.1, U7.4
/Lighting/RING_DIN: J4.2, R17.2
GND: C15.2, C16.2, C17.2, C18.2, C19.2, C20.2, C21.2, C22.2, C23.2, C24.2, C25.2, D1.1 (VSS), D2.1 (VSS), D3.1 (VSS), D4.1 (VSS), D5.1 (VSS), D6.1 (VSS), D7.1 (VSS), D8.1 (VSS), J4.3, U6.1, U6.3 (GND), U7.1, U7.3 (GND); also elsewhere on the board
LED_KEYS_3V3: U6.2; also elsewhere on the board
LED_RING_3V3: U7.2; also elsewhere on the board
VLED: C15.1, C16.1, C17.1, C18.1, C19.1, C20.1, C21.1, C22.1, C23.1, C24.1, C25.1, D1.3 (VDD), D2.3 (VDD), D3.3 (VDD), D4.3 (VDD), D5.3 (VDD), D6.3 (VDD), D7.3 (VDD), D8.3 (VDD), J4.1, U6.5 (VCC), U7.5 (VCC); also elsewhere on the board

Notes on the sheet:
Level shifters (3.3 V data to VLED logic)
Key LEDs (chain: keys 5-6-7-8-4-3-2-1)
Ring strip connector

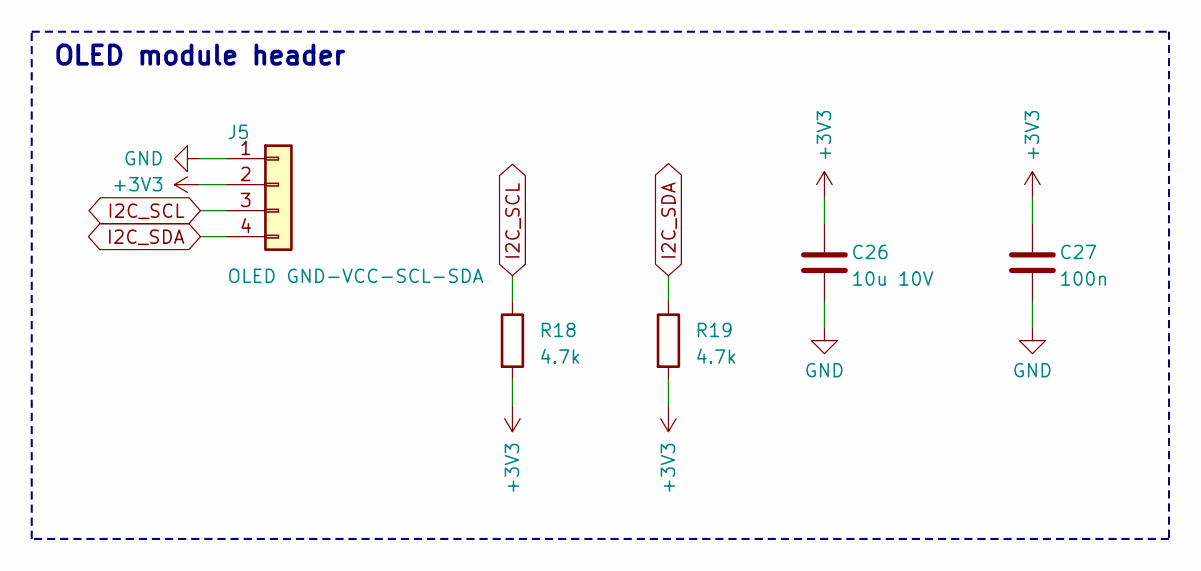
[picture p49: schematic display.kicad_sch, Deck-8 Rev A — Display: 0.96 in 128x64 OLED (I2C)]

Parts:
C26: 10u 10V; C_0603_1608Metric; MPN CL10A106KP8NNNC (10 V X5R); LCSC C19702
C27: 100n; C_0603_1608Metric; MPN CC0603KRX7R9BB104 (50 V X7R); LCSC C14663
J5: OLED GND-VCC-SCL-SDA; PinHeader_1x04_P2.54mm_Vertical; MPN 0.96 in 128x64 I2C OLED module (SSD1306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
R18, R19: 4.7k; R_0603_1608Metric; MPN UNI-ROYAL 0603WAF4701T5E; LCSC C23162

Connections:
+3V3: C26.1, C27.1, J5.2, R18.2, R19.2; also elsewhere on the board
GND: C26.2, C27.2, J5.1; also elsewhere on the board
I2C_SCL: J5.3, R18.1; also elsewhere on the board
I2C_SDA: J5.4, R19.1; also elsewhere on the board

Notes on the sheet:
OLED module header

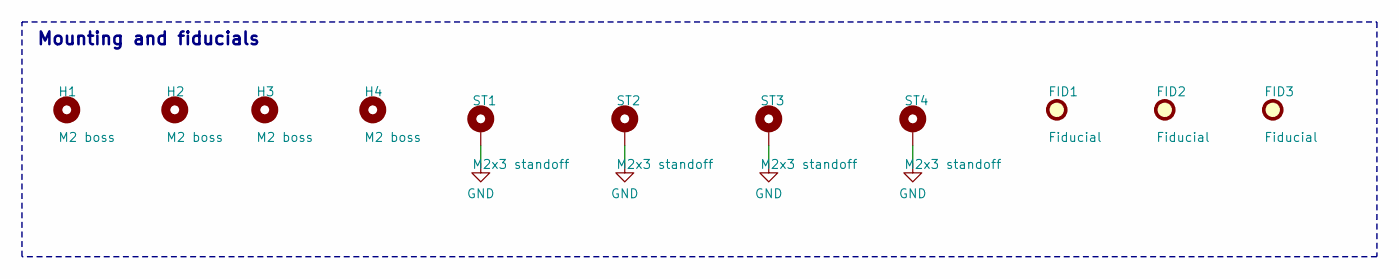
[picture p50: schematic mechanical.kicad_sch, Deck-8 Rev A — Mechanical: mounting, standoffs, fiducials]

Parts:
FID1, FID2, FID3: Fiducial; Fiducial_1mm_Mask2mm
H1, H2, H3, H4: M2 boss; MountingHole_2.2mm_M2
ST1, ST2, ST3, ST4: M2x3 standoff; Mounting_Wuerth_WA-SMSI-M2_H3mm_9774030243; MPN Wurth 9774030243

Connections:
GND: ST1.1, ST2.1, ST3.1, ST4.1; also elsewhere on the board

Notes on the sheet:
Mounting and fiducials

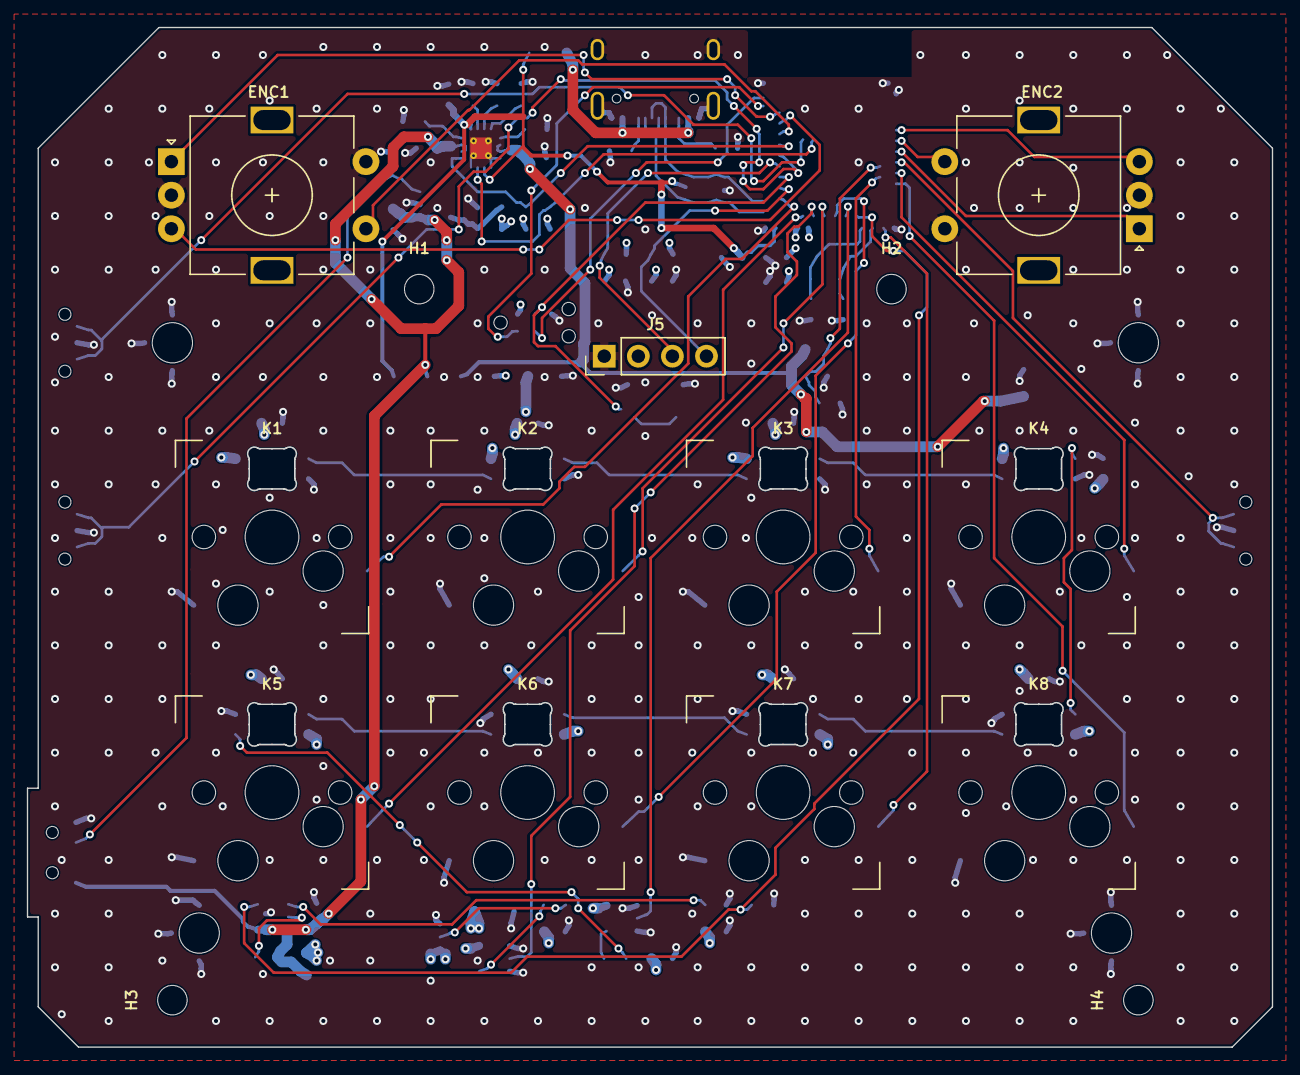
[picture p51: board deck8.kicad_pcb from above]

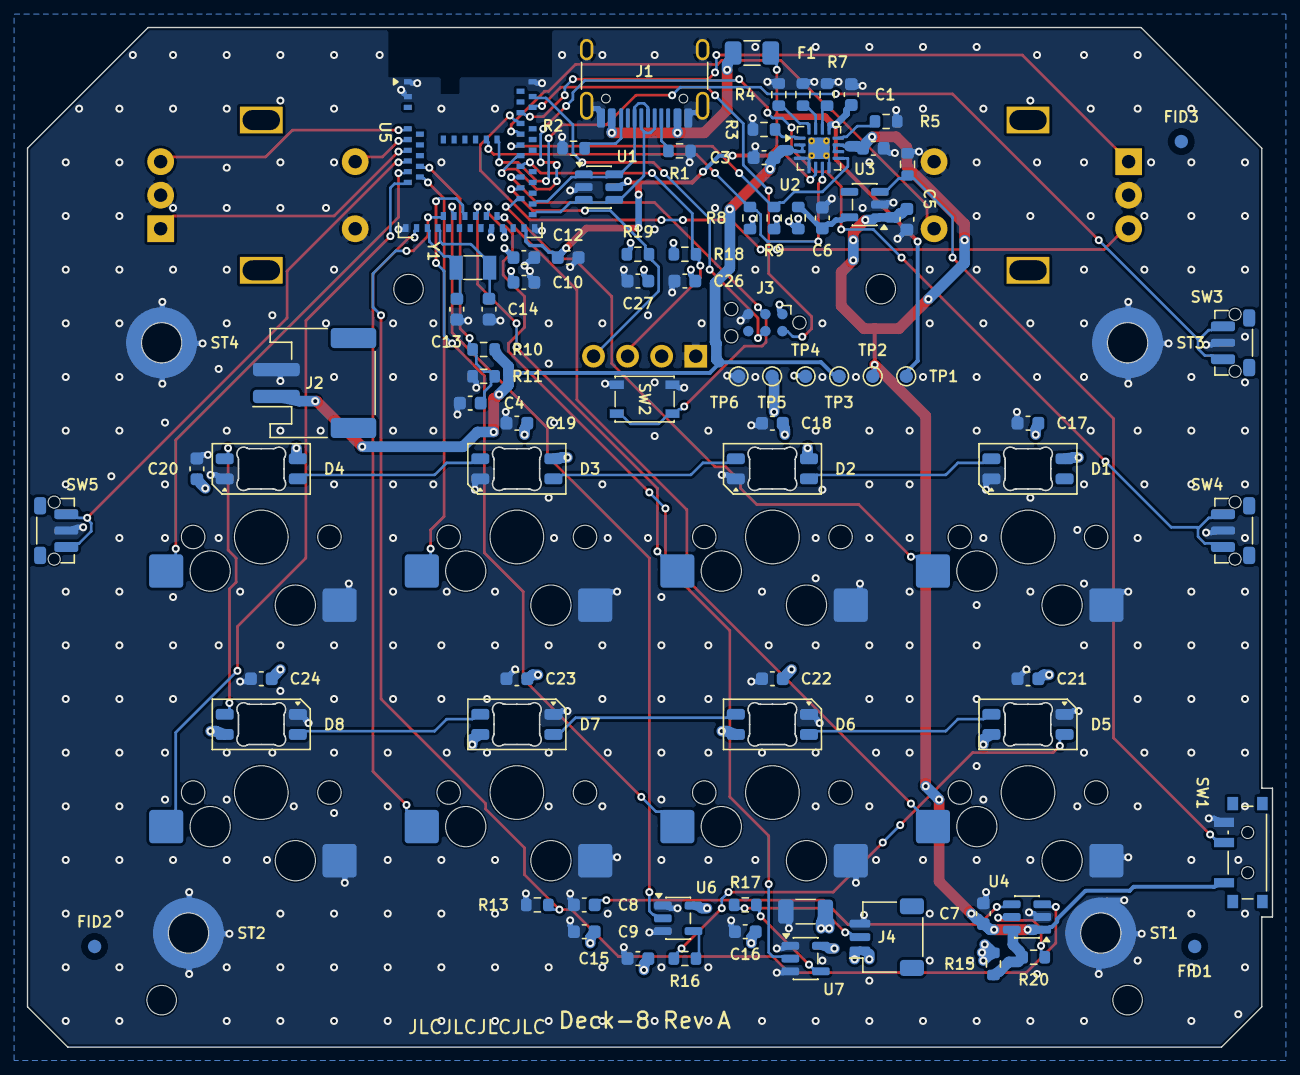
[picture p52: board deck8.kicad_pcb from below]

Board: 4 copper layers, 92.8 x 76.0 mm, 101 parts (86 on the bottom side), 62 nets.
