varaddorle007/deck-8/(commit log)

2026-10-23 Deck-8 Rev A: open-source macro pad (board, case, firmware)
    8 hot-swap keys, 2 knobs, OLED, key and ring lights, USB-C and Bluetooth.
    KiCad board and generators, Fusion case script, ZMK firmware, and the
    manufacturing files. Rev A is designed and checked but not yet built.
    [BUY-LIST.csv, Bottom_Tray.stl, Button_L1.stl, Button_L2.stl, Button_System.stl, Deck8_Bottom_Tray.stl, Deck8_Button_L1.stl, Deck8_Button_L2.stl]
2026-10-23 Add the PCB 3D STEP file
    [deck8_pcb.step]
